GJessopIII/Solar-Charger/README.md

# Solar-Charger
Documentation is located [here](https://solar-charger.rtfd.io)
