GJessopIII/Solar-Charger/docs/source/Pictures/solarcurve.png

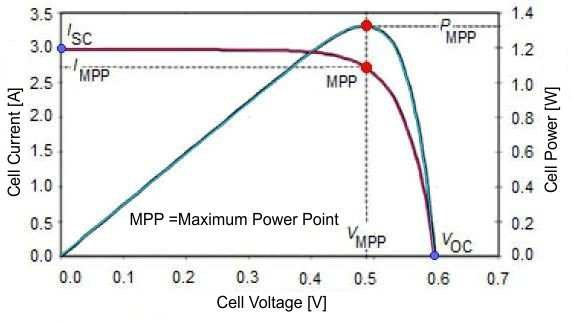
docs/source/Pictures/solarcurve.png
