GJessopIII/Solar-Charger/ChargePCB/BOM/DigikeyBOM.xlsx

Manufacturer Part Number | Manufacturer | Digi-Key Part Number | Packaging | Quantity | Unit Price | Extended Price | Quantity Available | US Tariff Status
LT3652IMSE#PBF | Linear Technology/Analog Devices | LT3652IMSE#PBF-ND | Tube | 1 | 8.13 | $8.13 | 4606
MBRS340 | ON Semiconductor | MBRS340FSCT-ND | Cut Tape (CT) | 2 | 0.56 | $1.12 | 19241 | Tariff Applied
RC0805FR-07787KL | Yageo | 311-787KCRCT-ND | Cut Tape (CT) | 1 | 0.1 | $0.10 | 121707 | Tariff Applied
1N914BWS | ON Semiconductor | 1N914BWSCT-ND | Cut Tape (CT) | 1 | 0.17 | $0.17 | 322480 | Tariff Applied
PCM12SMTR | C&K | 401-2016-1-ND | Cut Tape (CT) | 1 | 0.96 | $0.96 | 40581 | Tariff Applied
USB-A-S-F-B-SM2 | Samtec Inc. | SAM10366-ND | Tray | 1 | 1.54 | $1.54 | 575 | Tariff Eligible
RT4812GJ8F | Richtek USA Inc. | 1028-1512-1-ND | Cut Tape (CT) | 1 | 1.59 | $1.59 | 11574
GRM21BR61C226ME44L | Murata Electronics North America | 490-10747-1-ND | Cut Tape (CT) | 3 | 0.48 | $1.44 | 43802
SPM6530T-1R5M100 | TDK Corporation | 445-3881-1-ND | Cut Tape (CT) | 1 | 1.45 | $1.45 | 28949 | Tariff Applied
S-8261AAJMD-G2JT2G | ABLIC U.S.A. Inc. | 728-1034-1-ND | Cut Tape (CT) | 1 | 0.95 | $0.95 | 35846
UWX1C101MCL1GB | Nichicon | 493-2105-1-ND | Cut Tape (CT) | 1 | 0.29 | $0.29 | 326012
DMG6968UDM-7 | Diodes Incorporated | DMG6968UDMDICT-ND | Cut Tape (CT) | 1 | 0.56 | $0.56 | 59066 | Tariff Applied
ERA-6AEB104V | Panasonic Electronic Components | P100KDACT-ND | Cut Tape (CT) | 3 | 0.36 | $1.08 | 508500
ERA-6AEB3163V | Panasonic Electronic Components | P316KDACT-ND | Cut Tape (CT) | 1 | 0.36 | $0.36 | 8880
ERA-6AEB202V | Panasonic Electronic Components | P2.0KDACT-ND | Cut Tape (CT) | 1 | 0.36 | $0.36 | 66930
RC0805FR-07470RL | Yageo | 311-470CRCT-ND | Cut Tape (CT) | 1 | 0.1 | $0.10 | 1721676 | Tariff Applied
RC0805FR-07280KL | Yageo | 311-280KCRCT-ND | Cut Tape (CT) | 1 | 0.1 | $0.10 | 260186 | Tariff Applied
RC0805FR-071M15L | Yageo | 311-1.15MCRCT-ND | Cut Tape (CT) | 1 | 0.1 | $0.10 | 17927 | Tariff Applied
RUT2012FR100CS | Samsung Electro-Mechanics | 1276-6170-1-ND | Cut Tape (CT) | 1 | 0.3 | $0.30 | 94699 | Tariff Eligible
ERA-6AEB204V | Panasonic Electronic Components | P200KDACT-ND | Cut Tape (CT) | 1 | 0.36 | $0.36 | 142712
CPF0805B1M8E1 | TE Connectivity Passive Product | A103801CT-ND | Cut Tape (CT) | 1 | 0.55 | $0.55 | 8640
ERJ-6BWFR050V | Panasonic Electronic Components | P17581CT-ND | Cut Tape (CT) | 1 | 0.71 | $0.71 | 139929
RLB9012-100KL | Bourns Inc. | RLB9012-100KL-ND | Bag | 1 | 0.72 | $0.72 | 5815 | Tariff Eligible
BK-18650-PC2 | MPD (Memory Protection Devices) | BK-18650-PC2-ND | Tray | 1 | 3.89 | $3.89 | 5703 | Tariff Applied
