GJessopIII/Solar-Charger/LTC3652 Simulation/LT3652-Final.asc

C1: cap; 1µ
C2: cap; 10µ
C3: cap; 100µ
C4: cap; 0.15m; Rser=0.15
C6: cap; 10µ
D1: schottky; MBRS340
D2: diode; 1N914
D3: schottky; MBRS340
L1: ind; 10µ
R1: res; 0.05
R2: res; 787k
R3: res; 316k
R4: res; 1.15Meg
R5: res; 280k
R6: res; 100k
R7: res; 100k
R8: res; 0.1
U1: LT3652
U2: diode; PhotoCell
Named nets: IN, 0, OUT
.subckt PhotoCell B A
C1 A B 1n
V1 N001 B  PWL(0 0 3u 17.7)
D1 N001 A S2
R1 A N001 75
.model S2 D(Ron=.1 Ilimit=1.2 epsilon=.5)
.ends
.ic V(OUT)=3.0
.tran 3m
