GJessopIII/Solar-Charger/LTC3652 Simulation/LT3652-Sim.asc

C1: cap; 1µ
C2: cap; 10µ; Rser=0.003
C3: cap; .15m; Rser=0.15
C4: cap; 10µ
C5: cap; 4.7µ
C6: cap; 100µ; Rser=0.003
D1: diode; 1N914
D2: schottky; MBRS340
D3: schottky; MBRS140
D4: diode; 1N4148
D5: zener; BZX84C6V2L
L1: ind; 22µ; Ipk=1.7 Rser=0.11 Rpar=21068 Cpar=5.6p mfg="Wurth Elektronik" pn="7447779122 WE-PD M"
NTC: res; 10K
R1: res; 20m
R2: res; 499k
R3: res; 100K
R4: res; 1Meg
R5: res; 170k
R6: res; 910
R7: res; 138k
R8: res; 330k
R9: res; 10
U1: LT3652
U2: diode; PhotoCell
Named nets: 0, IN, OUT
.tran 3m
.subckt PhotoCell B A
C1 A B 1n
V1 N001 B  PWL(0 0 3u 17.7)
D1 N001 A S2
R1 A N001 75
.model S2 D(Ron=.1 Ilimit=0.1 epsilon=.5)
.ends
LT3652 - Power Tracking 2A Battery Charger for Solar Power
1A Solar Panel Powered 3-Stage 12V Lead-Acid Fast/Float Charger
Input: Up to 16V     Output: Up to 14.4V @ 1A
Note:
  If the simulation model is not found please update with the "Sync Release" command from the "Tools" menu.
  It remains the customer's responsibility to verify proper and reliable operation in the actual application.
  Component substitution and printed circuit board layout may significantly affect circuit performance or reliability
  Contact your local sales representative for assistance. This circuit is distributed to customers only for use with LTC parts
  Copyright © 2011 Linear Technology Inc. All rights reserved.
.ic V(OUT)=3.2
