GJessopIII/Solar-Charger/ChargePCB/ChargePCB.kicad_pcb

## KiCad design ChargePCB/ChargePCB.kicad_pcb (2019-06-04)

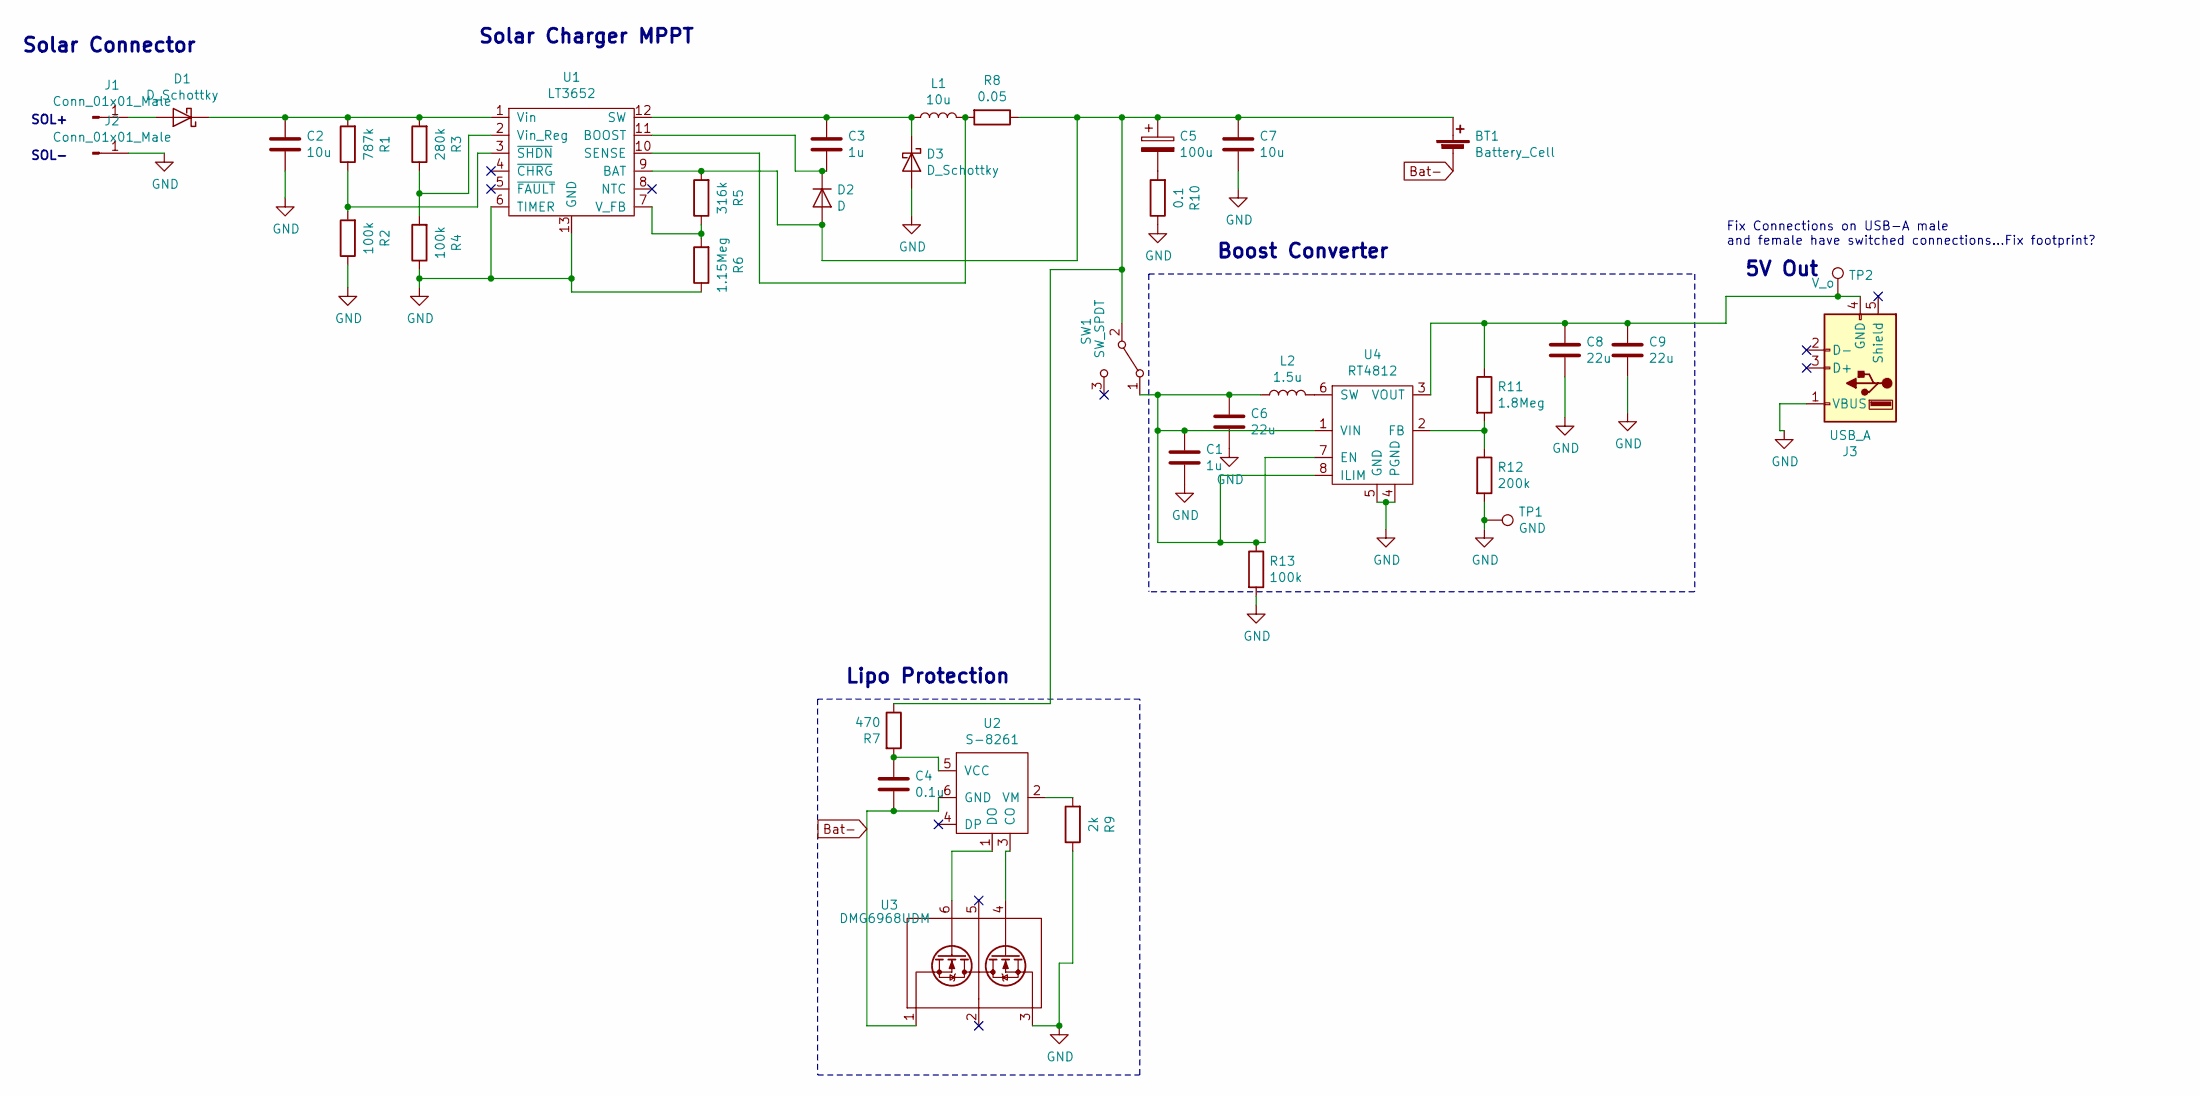
[picture p4: schematic ChargePCB.sch, Solar Charge]

Parts:
BT1: Battery_Cell; BatteryHolder_MPD_BH-18650-PC2
C1, C3: 1u; C_0805_2012Metric
C2, C7: 10u; C_0805_2012Metric
C4: 0.1u; C_0805_2012Metric
C5: 100u; CP_Elec_6.3x5.4_Nichicon
C6, C8, C9: 22u; C_0805_2012Metric
D1, D3: D_Schottky; D_SMC
D2: D; D_SOD-323F
J1, J2: Conn_01x01_Male; SolderWirePad_1x01_Drill0.8mm
J3: USB_A; USB_A_CNCTech_1001-011-01101_Horizontal
L1: 10u; L_Axial_L20.0mm_D8.0mm_P5.08mm_Vertical
L2: 1.5u; L_Bourns-SRN6028
R1: 787k; R_0805_2012Metric
R2, R4, R13: 100k; R_0805_2012Metric
R3: 280k; R_0805_2012Metric
R5: 316k; R_0805_2012Metric
R6: 1.15Meg; R_0805_2012Metric
R7: 470; R_0805_2012Metric
R8: 0.05; R_0805_2012Metric
R9: 2k; R_0805_2012Metric
R10: 0.1; R_0805_2012Metric
R11: 1.8Meg; R_0805_2012Metric
R12: 200k; R_0805_2012Metric
SW1: SW_SPDT; SW_SPDT_PCM12
TP1: GND; TestPoint_Plated_Hole_D2.0mm
TP2: V_o; TestPoint_Plated_Hole_D2.0mm
U1: LT3652; MSOP-12-1EP_3x4mm_P0.65mm_EP1.65x2.85mm
U2: S-8261; SOT-23-6
U3: DMG6968UDM; SOT-23-6
U4: RT4812; TSOT-23-8

Connections:
Bat-: BT1.2 (-), C4.2, U2.6 (GND), U3.1
GND: C1.2, C2.2, C6.2, C7.2, C8.2, C9.2, D3.2 (A), J2.1, J3.1 (VBUS), R2.1, R4.1, R6.1, R9.1, R10.1, R12.2, R13.2, TP1.1, U1.6 (TIMER), U1.13 (GND), U3.3, U4.4 (PGND), U4.5 (GND)
unnamed: BT1.1 (+), C5.1, C7.1, D2.2 (A), R5.2, R7.1, R8.1, SW1.2 (B), U1.9 (BAT)
unnamed: C1.1, C6.1, L2.1, R13.1, SW1.1 (A), U4.1 (VIN), U4.7 (EN), U4.8 (ILIM)
unnamed: C2.1, D1.1 (K), R1.2, R3.2, U1.1 (Vin)
unnamed: C3.1, D3.1 (K), L1.1, U1.12 (SW)
unnamed: C3.2, D2.1 (K), U1.11 (BOOST)
unnamed: C4.1, R7.2, U2.5 (VCC)
unnamed: C5.2, R10.2
unnamed: C8.1, C9.1, J3.4 (GND), R11.1, TP2.1, U4.3 (VOUT)
unnamed: D1.2 (A), J1.1
unnamed: L1.2, R8.2, U1.10 (SENSE)
unnamed: L2.2, U4.6 (SW)
unnamed: R1.1, R2.2, U1.3 (~SHDN)
unnamed: R3.1, R4.2, U1.2 (Vin_Reg)
unnamed: R5.1, R6.2, U1.7 (V_FB)
unnamed: R9.2, U2.2 (VM)
unnamed: R11.2, R12.1, U4.2 (FB)
unnamed: U2.1 (DO), U3.6
unnamed: U2.3 (CO), U3.4

Notes on the sheet:
Boost Converter
Solar Charger MPPT
SOL+
SOL-
5V Out
Lipo Protection
Solar Connector
Fix Connections on USB-A male and female have switched connections...Fix footprint?

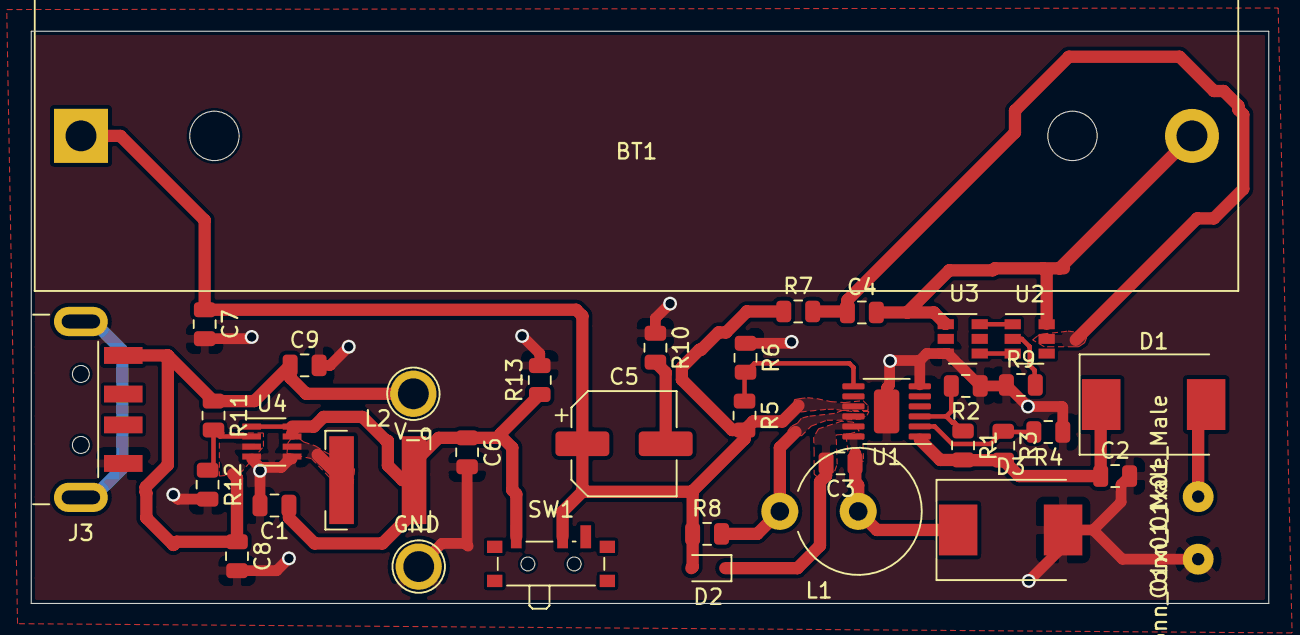
[picture p5: board ChargePCB.kicad_pcb from above]

Board: 2 copper layers, 80.2 x 37.1 mm, 38 parts (0 on the bottom side), 20 nets.
