GJessopIII/Solar-Charger/(commit log)

2019-05-17 changed silkscreen to say new repository
    [ChargePCB.kicad_pcb]
2019-05-29 Fixed zone priority issues
    [ChargePCB.kicad_pcb]
2019-06-03 Fixing USB polarity, Lipo Protection, and 1.5uH footprint error
    [ChargePCB.kicad_pcb, ChargePCB.sch]
